bsaletta/Shiela2/README.md

# Shiela2
This is the folder where we will store all of our code and what not, enjoy!
