bsaletta/Shiela2/Final Report/figures/Arduino UNO.png

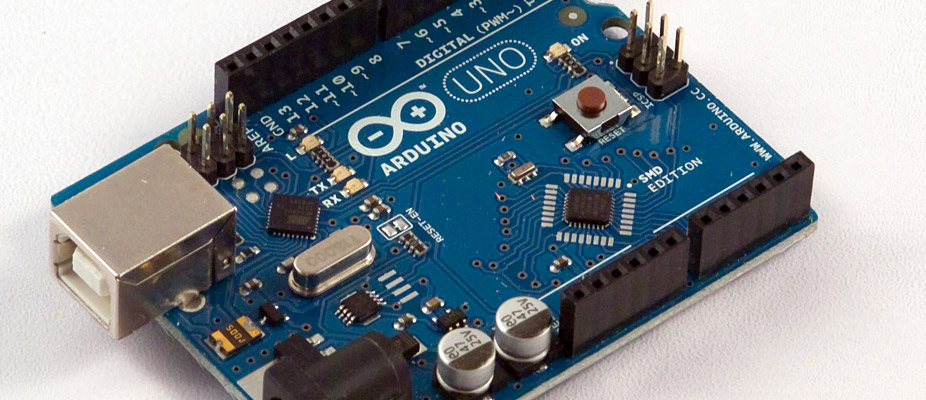
Final Report/figures/Arduino UNO.png
