bsaletta/Shiela2/Final Report/figures/batteries.jpg

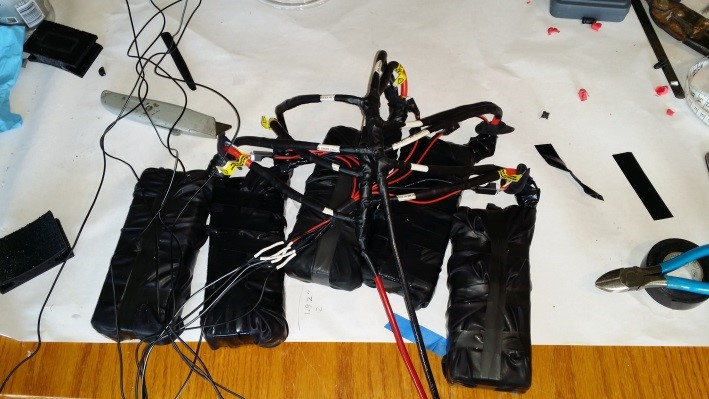
Final Report/figures/batteries.jpg
