bsaletta/Shiela2/Final Report/figures/brains.jpg

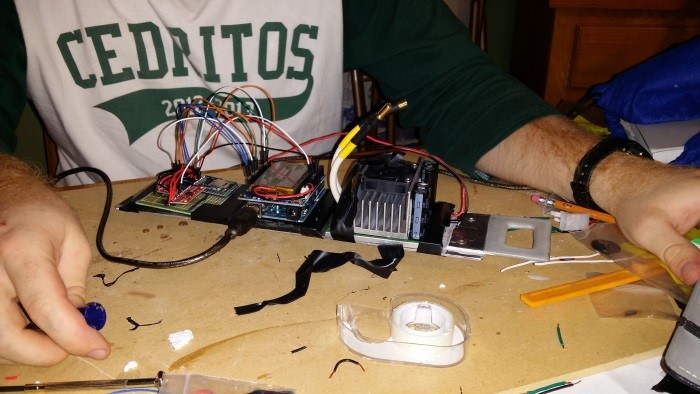
Final Report/figures/brains.jpg
