bsaletta/Shiela2/Final Report/figures/camera.jpg

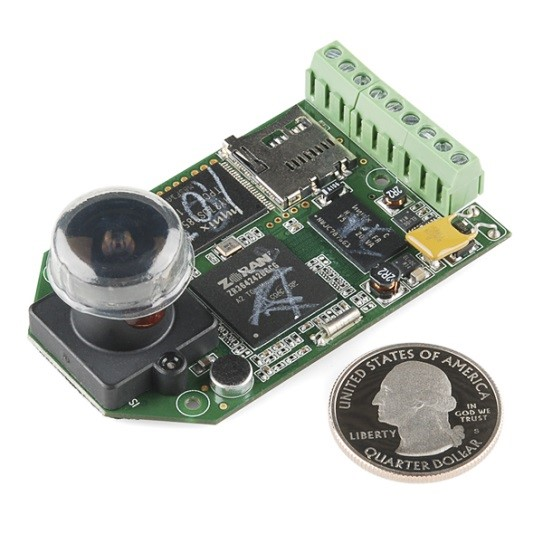
Final Report/figures/camera.jpg
