bsaletta/Shiela2/Final Report/figures/CameraDome.jpg

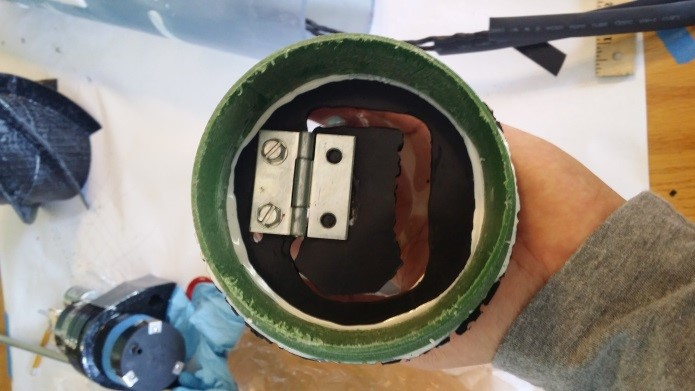
Final Report/figures/CameraDome.jpg
