bsaletta/Shiela2/Final Report/figures/Cephalopod Skin.png

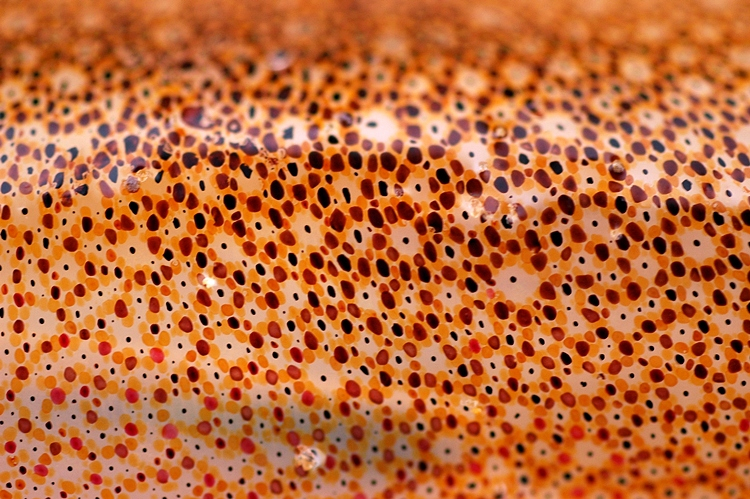
Final Report/figures/Cephalopod Skin.png
