bsaletta/Shiela2/Final Report/figures/charger.jpg

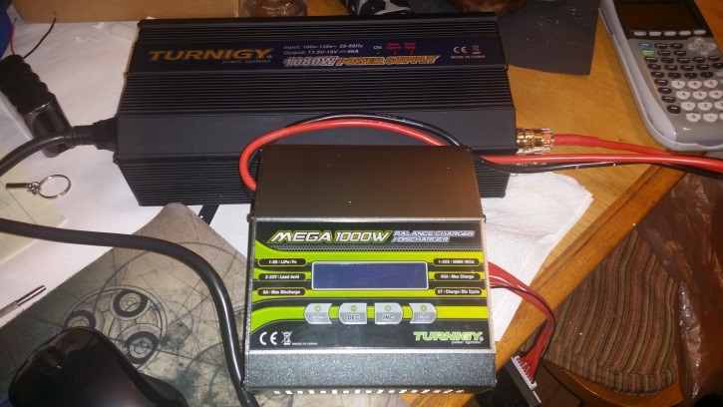
Final Report/figures/charger.jpg
