bsaletta/Shiela2/Final Report/figures/CLT.png

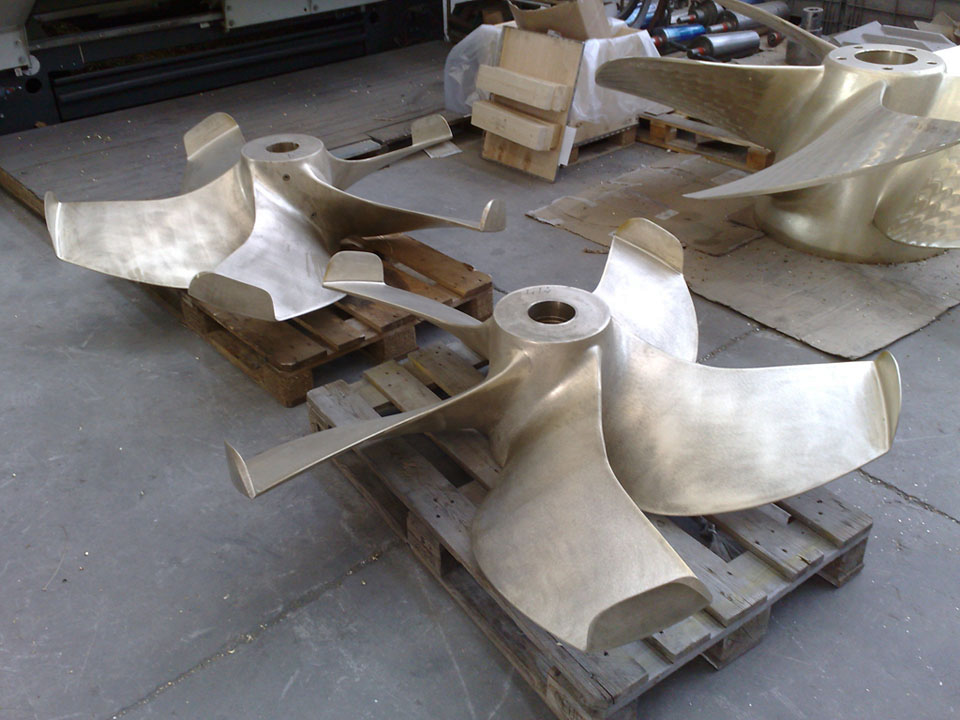
Final Report/figures/CLT.png
