bsaletta/Shiela2/Final Report/figures/Conformal Coating.png

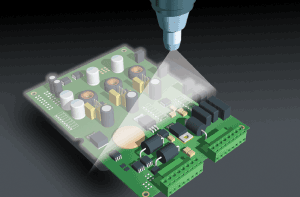
Final Report/figures/Conformal Coating.png
