bsaletta/Shiela2/Final Report/figures/Control Volume B.png

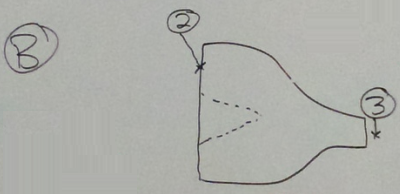
Final Report/figures/Control Volume B.png
