bsaletta/Shiela2/Final Report/figures/Control Volume C.png

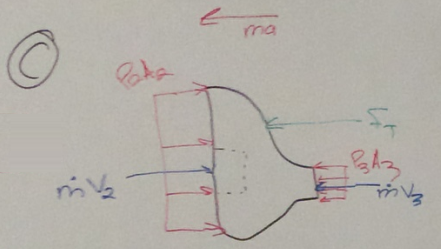
Final Report/figures/Control Volume C.png
