bsaletta/Shiela2/Final Report/figures/Control Volume D.png

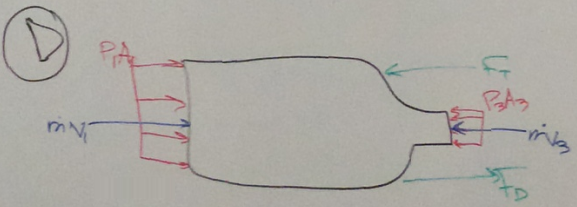
Final Report/figures/Control Volume D.png
