bsaletta/Shiela2/Final Report/figures/Ctrl Volume A.png

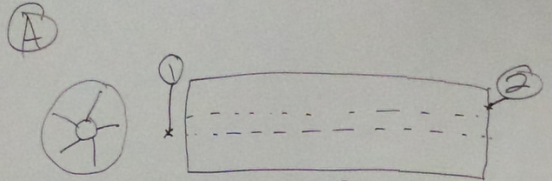
Final Report/figures/Ctrl Volume A.png
