bsaletta/Shiela2/Final Report/figures/Currents.png

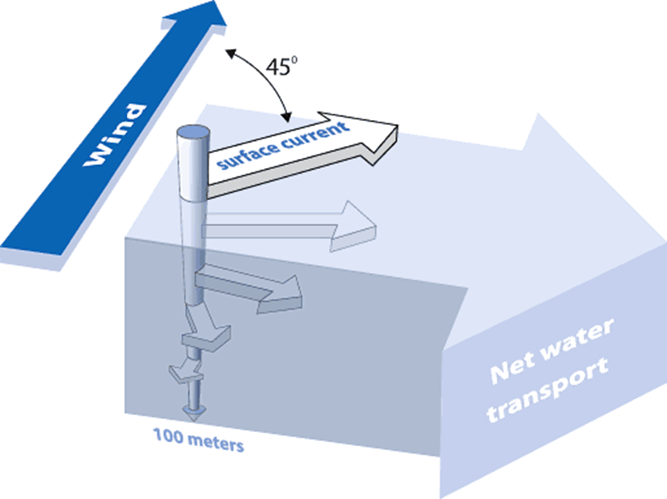
Final Report/figures/Currents.png
