bsaletta/Shiela2/Final Report/figures/guiOrientation.png

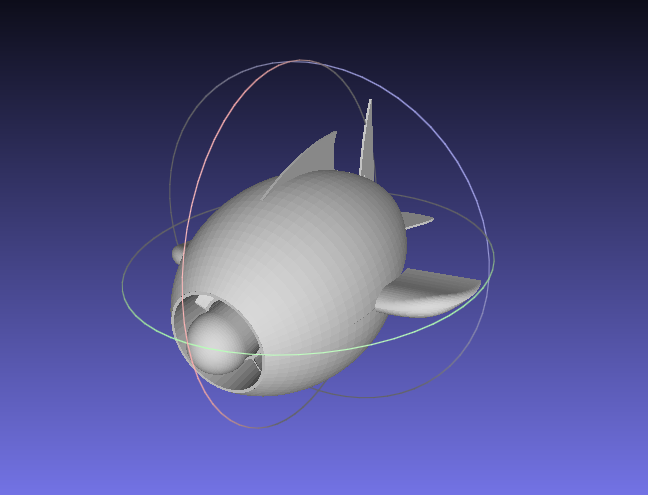
Final Report/figures/guiOrientation.png
