bsaletta/Shiela2/Final Report/figures/loctite.jpg

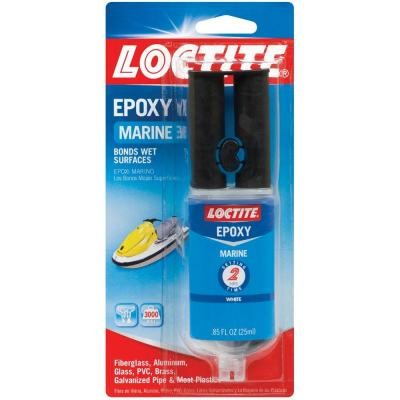
Final Report/figures/loctite.jpg
