bsaletta/Shiela2/Final Report/figures/Nozzel Minor Losses.jpg

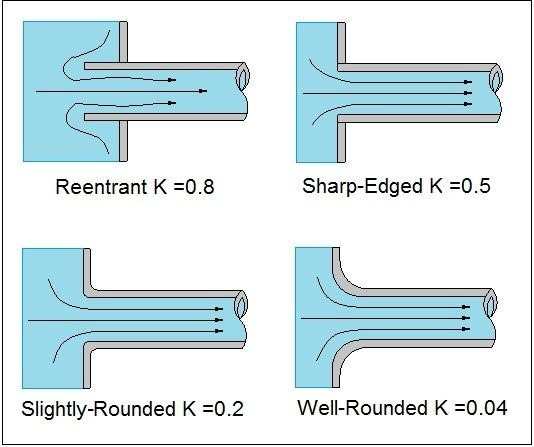
Final Report/figures/Nozzel Minor Losses.jpg
