bsaletta/Shiela2/Final Report/figures/Owl Stealth.png

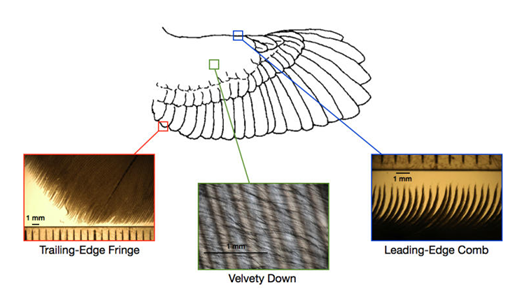
Final Report/figures/Owl Stealth.png
