bsaletta/Shiela2/Final Report/figures/PHFront.jpg

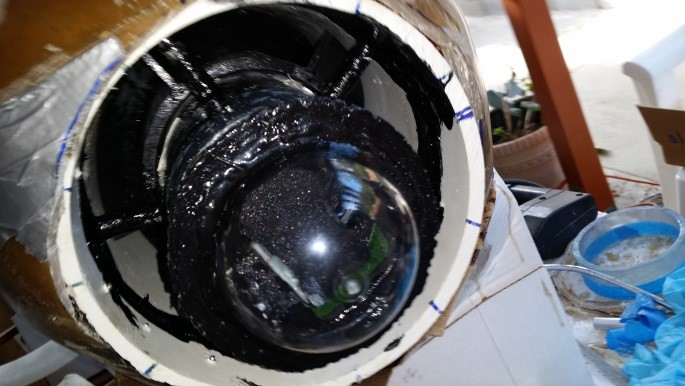
Final Report/figures/PHFront.jpg
