bsaletta/Shiela2/Final Report/figures/Pitch Roll Yaw.png

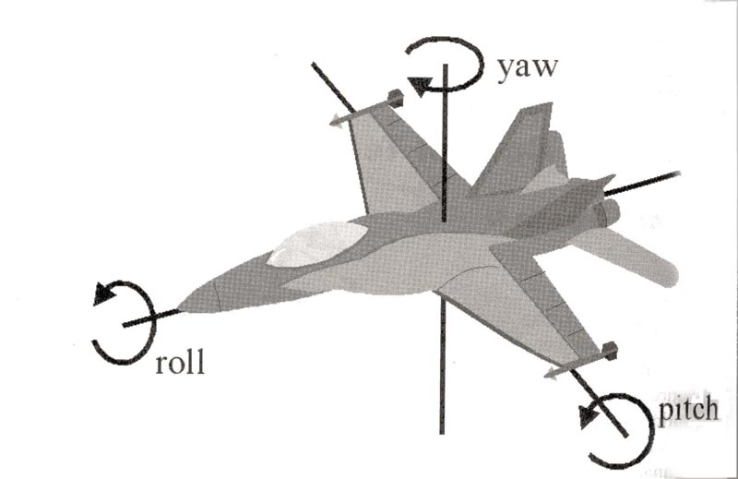
Final Report/figures/Pitch Roll Yaw.png
