bsaletta/Shiela2/Final Report/figures/Potting.png

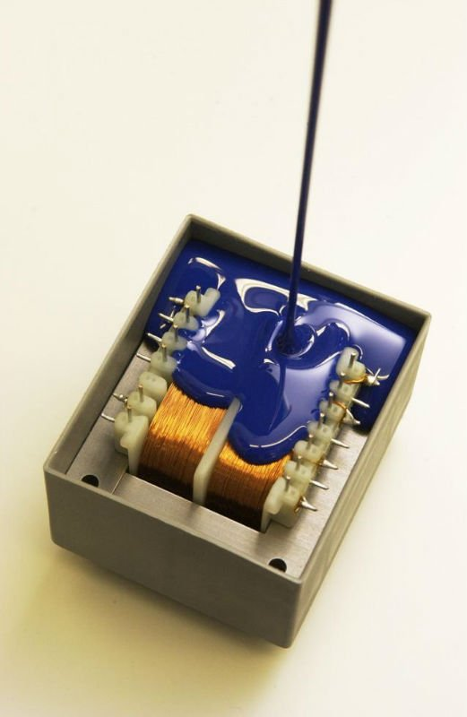
Final Report/figures/Potting.png
