bsaletta/Shiela2/Final Report/figures/Pressure Hull.png

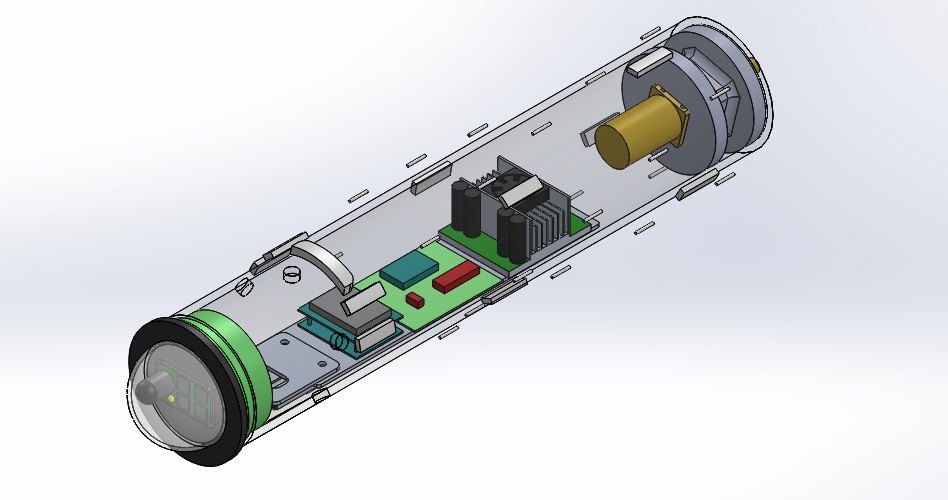
Final Report/figures/Pressure Hull.png
