bsaletta/Shiela2/Final Report/figures/sabertooth.png

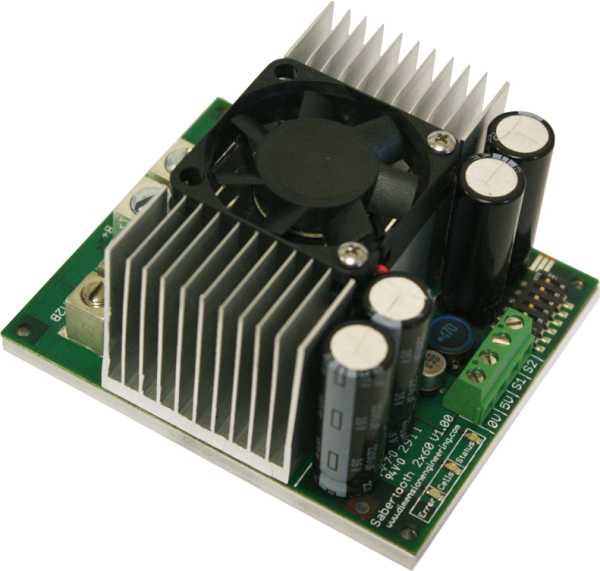
Final Report/figures/sabertooth.png
