bsaletta/Shiela2/Final Report/figures/sd.jpg

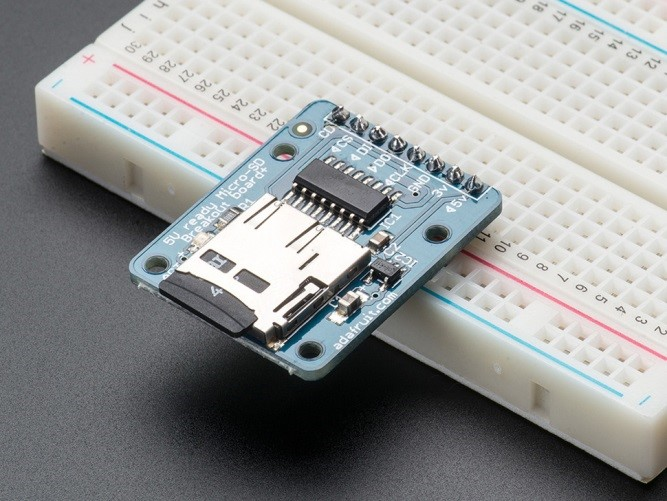
Final Report/figures/sd.jpg
