bsaletta/Shiela2/Final Report/figures/Section View.png

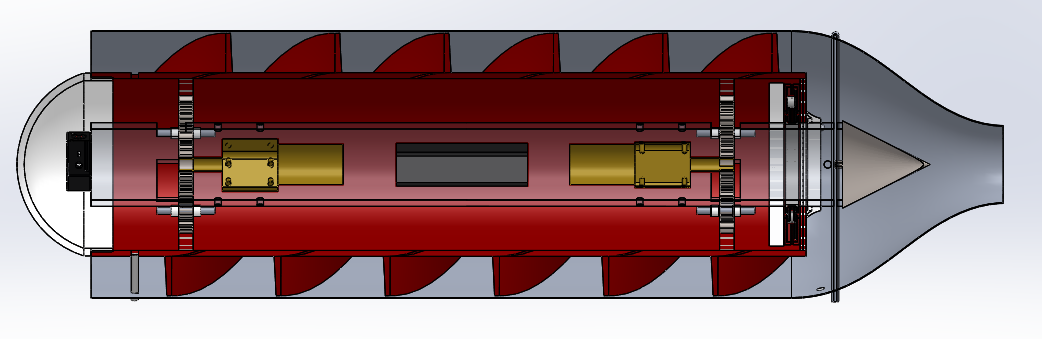
Final Report/figures/Section View.png
