bsaletta/Shiela2/Final Report/figures/Shark Money.png

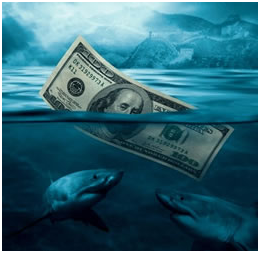
Final Report/figures/Shark Money.png
