bsaletta/Shiela2/Final Report/figures/Shark Skin.png

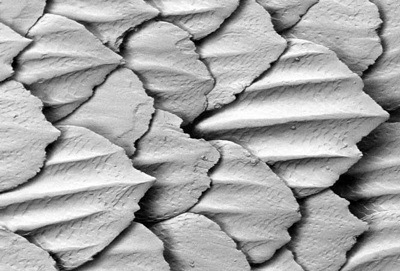
Final Report/figures/Shark Skin.png
