bsaletta/Shiela2/Final Report/figures/singleBattery.jpg

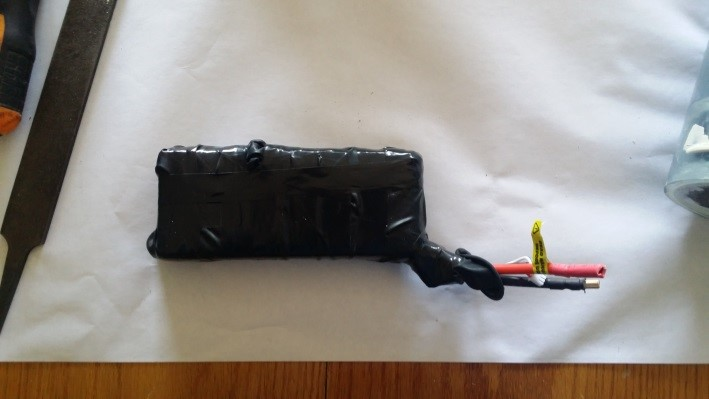
Final Report/figures/singleBattery.jpg
