bsaletta/Shiela2/Final Report/figures/Smart Duct.png

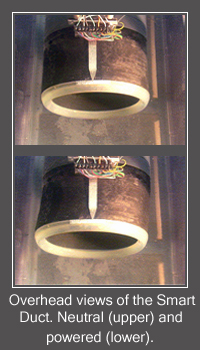
Final Report/figures/Smart Duct.png
