bsaletta/Shiela2/Final Report/figures/standoffs.jpg

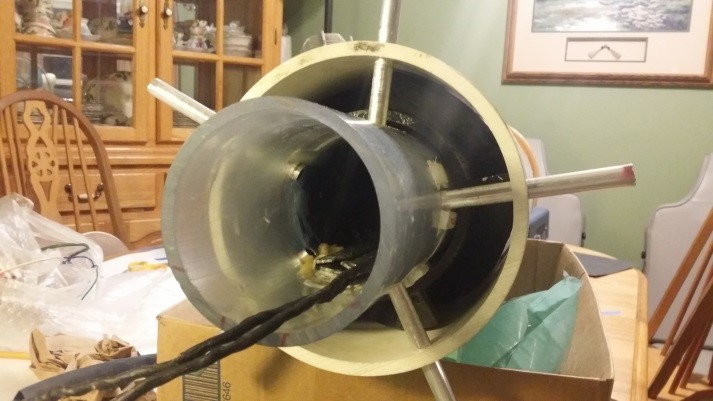
Final Report/figures/standoffs.jpg
