bsaletta/Shiela2/Final Report/figures/Submarine Design.png

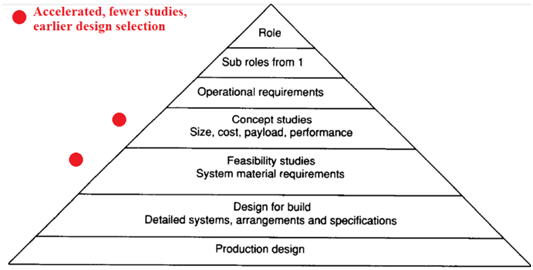
Final Report/figures/Submarine Design.png
