bsaletta/Shiela2/Final Report/figures/Submarine Hydrostatics.png

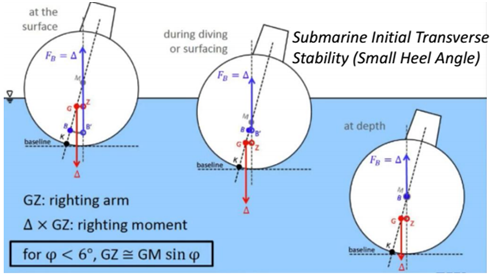
Final Report/figures/Submarine Hydrostatics.png
