bsaletta/Shiela2/Final Report/figures/Submarine Stealth.png

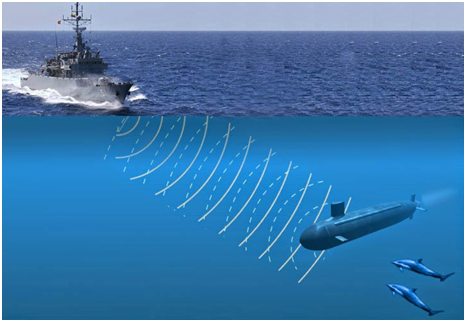
Final Report/figures/Submarine Stealth.png
