bsaletta/Shiela2/Final Report/figures/Thrust Augmentation.png

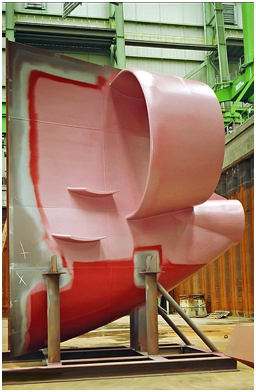
Final Report/figures/Thrust Augmentation.png
