bsaletta/Shiela2/Final Report/figures/tray.jpg

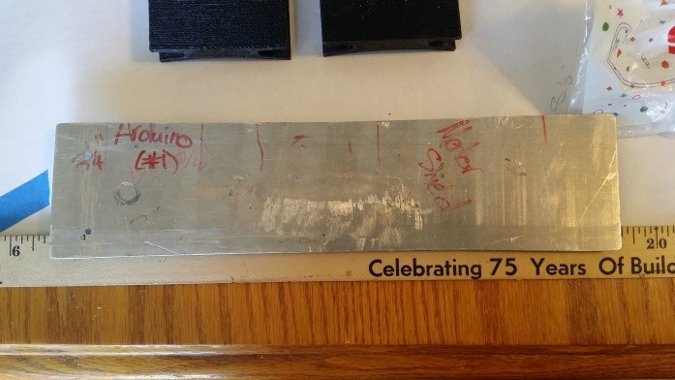
Final Report/figures/tray.jpg
