bsaletta/Shiela2/Final Report/figures/Vane Shell Von Mises Isometric.jpg

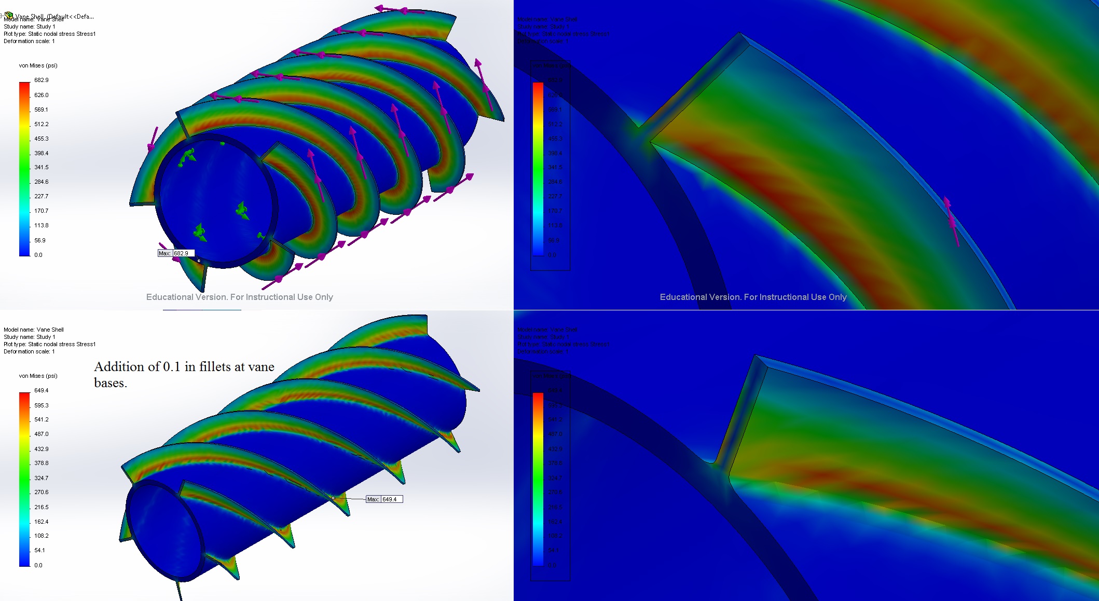
Final Report/figures/Vane Shell Von Mises Isometric.jpg
