bsaletta/Shiela2/Final Report/figures/Vantablack.png

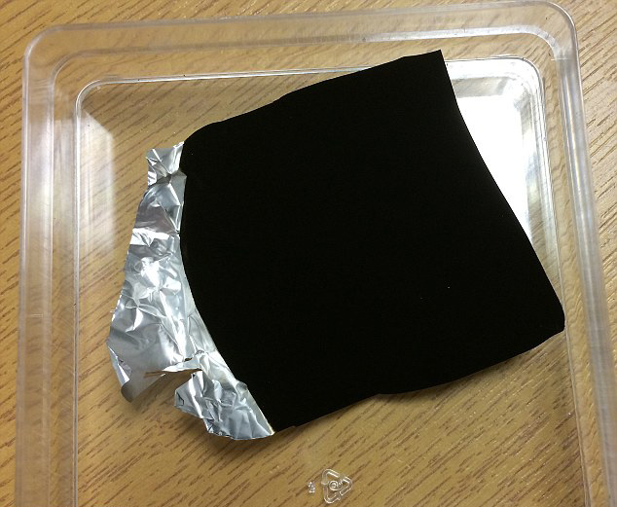
Final Report/figures/Vantablack.png
