bsaletta/Shiela2/Final Report/figures/Vortex Generators.png

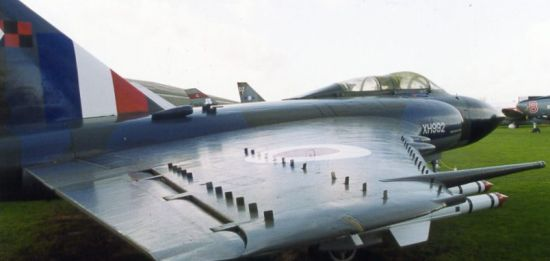
Final Report/figures/Vortex Generators.png
