bsaletta/Shiela2/Final Report/figures/Wanda II.png

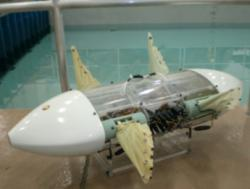
Final Report/figures/Wanda II.png
