bsaletta/Shiela2/FinalGUI/data/Full Vehicle Processing.obj

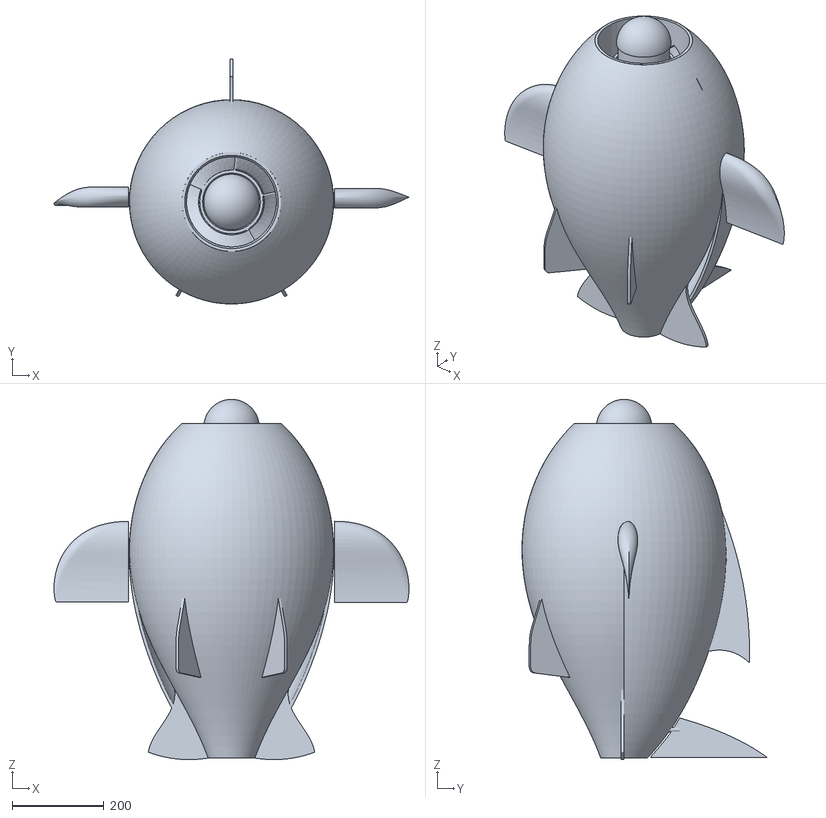
[picture p76: CAD file, 2015-03-17]
FinalGUI/data/Full Vehicle Processing.obj
772.5 x 533.3 x 783.9
