bsaletta/Shiela2/FinalGUI/data/Test.obj

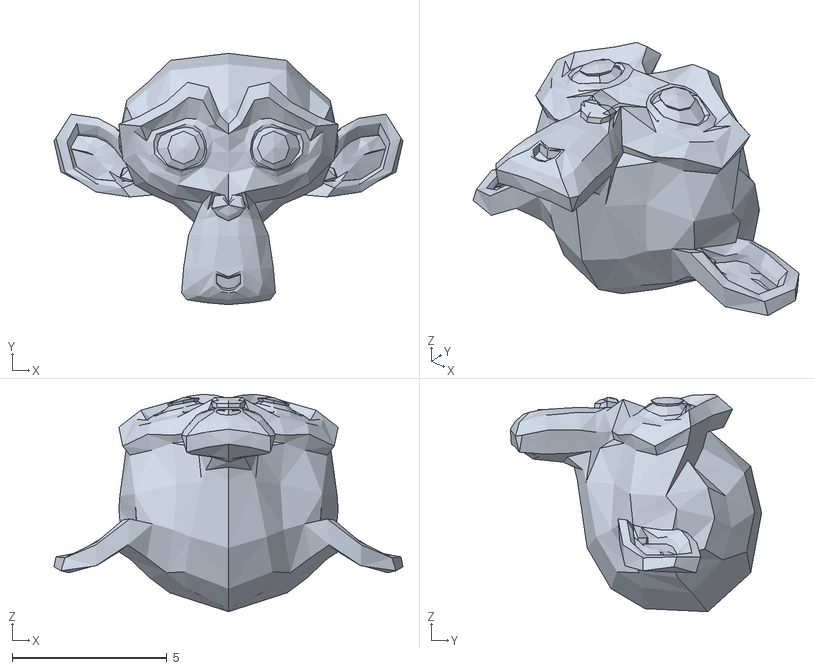
[picture p77: CAD file, 2015-01-27]
FinalGUI/data/Test.obj
11.3 x 8.11 x 7.01
