bsaletta/Shiela2/Final Report/figures/Test Tank.png

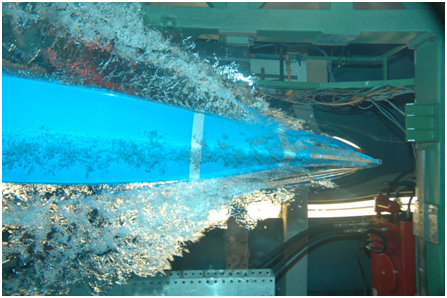
Final Report/figures/Test Tank.png
