bsaletta/Shiela2/(threads)

Thread 1 (2015-01-22):

Velocity creep

bsaletta, 2015-01-22:
In the filter test file the velocity is still creeping, it seems to be a linear... fix it!
