bsaletta/Shiela2/Filter_Tester/Filter_Tester_Processing/Filter_Tester_Processing.pde

import processing.serial.*;

int lf=10; // the ASCII value of the '\n' character
String reading=null;
Serial arduino; //create serial port
PFont f; //Create a font for the text to be displayed
void setup(){
 println(Serial.list());
 //WARNING!!! THIS LINE IS SPECIFIC TO YOUR COMPUTER
 //READ OUTPUT OF Serial.list THEN EDIT THIS LINE BEFORE CONTINUING
 //!!                     VVVVVVVVVVVVVVVVVVVVVVVVVVVVVVVVV
  arduino=new Serial(this,Serial.list()[Serial.list().length-1],115200);
 //!!                     ^^^^^^^^^^^^^^^^^^^^^^^^^^^^^^^^^ 
 arduino.clear();
 reading=arduino.readStringUntil(lf);
 reading=null;//throw out first value incase we start in the middle of a line
  
 size(1000,300);// set the window size
 f=createFont("Times New Roman",16,true); //Creates font arial 16pt ant-aliased

 String message="Reading Values";
 char[] msg=message.toCharArray();
 for(int i=0;i<msg.length;i++){
    arduino.write(msg[i]); 
 }
}
int oldVals[]=new int[1000]; //Create containers for old values
int oldValfs[]=new int[1000];
int oldValvs[]=new int[1000];

void draw(){
 if(arduino.available()>0){
  
  reading=arduino.readStringUntil(lf);
  
  if(reading!=null && reading!=""){
    stroke(255);
  fill(255);            //clear screen by drawing a white rectangle
  rect(0,0,1000,300); //the size of the whole screen
  String input[]=split(reading,','); //break into 2 values;
  float measured=Float.parseFloat(input[0]);
  float filtered=Float.parseFloat(input[1]);//Turn strings into Float values
  //float vx=Float.parseFloat(input[2]);
  //float x=Float.parseFloat(input[3]); 
   float vx=0;
   float x=0;
   fill(0);
   line(150,0,150,1000);
   textFont(f); //Set the Created font as the text font
   text("Velocity: "+vx,800,20);
   text("Position: "+x,800,40);
  
  int val=(int)((measured+2)*150)-150; //Scale values to window
  int valf=(int)((filtered+2)*150)-150;
  int valv=(int)(vx*200)+150;
 
  //Here val in unfiltered and valf is filtered
  
  int vals[]=new int[1000];
  int valfs[]=new int[1000];
  int valvs[]=new int[1000];
  
  vals[0]=val; // add the new measurement to the 
  valfs[0]=valf;// front of the array
  valvs[0]=valv;
  
  for(int i=1;i<vals.length;i++){ // These for loops populate
    vals[i]=oldVals[i-1];         // the rest of the value 
  }                               // arrays from preveious 
  for(int i=1;i<valfs.length;i++){ // measurements
    valfs[i]=oldValfs[i-1];
  }
  for(int i=1;i<valvs.length;i++){
    valvs[i]=oldValvs[i-1];
  }
  
  stroke(200); //Set measured line to grey
  for(int i=0;i<vals.length-1;i++){
     line(i,vals[i],i+1,vals[i+1]);
  }
  stroke(#FF0000); //Set filtered to red
  for(int i=0;i<valfs.length-1;i++){
    line(i,valfs[i],i+1,valfs[i+1]);
  }
  //stroke(#33CC33); //Set Velocity to Green
  //for(int i=0;i<valvs.length-1;i++){
  //  line(i,valvs[i],i+1,valvs[i+1]);
 // }
  oldVals=vals;
  oldValfs=valfs;
  oldValvs=valvs;
  }
  
 } 
}
