bsaletta/Shiela2/(commit log)

2015-01-15 Added arduino code, currently empty file
2015-01-19 Added the filter tester project
2015-01-19 Created a filter testing application in processing
2015-01-22 Added angle filtering to the processing sketch
2015-01-22 Added some loss of sigfigs to correct for mounting error. Maybe...
    [Filter_Tester.ino]
2015-01-22 Created a program to work on the 3D gui thing hopefully it works.
    There is also a cube "Test.obj" to play with
    [Test.obj]
2015-01-25 Worked on the stupid filter
    Made some steps. But the more I filter the less accuracy there is... So
    it still needs some work... And thats what I'm here for!
2015-01-26 Simple Test Code to Power Motor based on Water Lvl
    Wrote us this code to try today either at the meeting or when I pick up
    the motor/shield/battery from Brian. Feel Free to make any changes
    :dancers:
2015-01-27 Worked a bit on the gui_testing
    Went from a cube to a monkey. Got the monkey to move with the mouse...
    Tried to explain it a bit with comments.
    [Test.obj]
2015-01-31 Added a second version of the filter tester
    The first version wasn't playing nice so I'm starting from scratch...
    ish
2015-01-31 Working on the filter
2015-02-01 Doing some more work on filter
    Workin...
2015-02-05 MORE WORK HARDER
    I hate the filter....
2015-02-05 Working more on the filter
2015-02-07 Yea...HackHD Code is this Simple
    Wrote up a simple code to: Engage auto-record, record for 10 seconds,
    and disengage auto-record. We can take off the 10 second limit very
    easily and have it record 1 hour videos until the SD card fills up. At
    that point the camera finishes saving everything and shuts down.
2015-02-10 More filter work
    I have yet to test this one but I think maybe the code will work this
    time, if not I have a nice place to do a SECOND filter! What up!
2015-02-10 Filter work
    Few minor bug fixes, some how not working... gotta do some testing!
    [Filter_Tester_V4.ino]
2015-02-11 Filter Changes
    Changed from rectilinear to magnitude and Direction, Looks ok, now I
    know more of what to filter!
2015-02-12 Got the filter to work!... A bit
    Acceleration looks pretty clean, heading needs some work but the rest of
    it is ok... Working on velocity and translating to the global plane
2015-02-15 More filter work
2015-02-26 Set up final GUI
    Check out the final gui processing sketch, it should have all the bones
    needed to get this sucker off the ground! Also some changes to the final
    report, mostly spelling...
    [Test.obj]
2015-03-03 Some sensor work
2015-03-04 Filter again
2015-03-04 Uploading the video and made some filter changes
    The filter file should be fairly well comented
2015-03-06 Filter tweak
    Added acceptible difference in angae
2015-03-07 Filter and GUI Updated
    They have been updated! Enjoy
2015-03-12 Saving IMU Position and Orientation to SD Card
    Added a bunch of essential Definitions.
    Also added the For Loops to save the individual values in the arrays.
    Let me know if this works!
2015-03-12 Worked on the Final Report and The Final Filter
    Got the SD card to work and got through most of the research summaries.
2015-03-14 worked on orientation
    [Full Vehicle Processing.obj]
2015-03-17 Tried to work on the orientation
    [Full Vehicle Processing.obj]
